PaulRB/WemosSensor/README.md

# WemosSensor
Temp/Humidity/Barometric Pressure Sensor for WeMos D1 mini
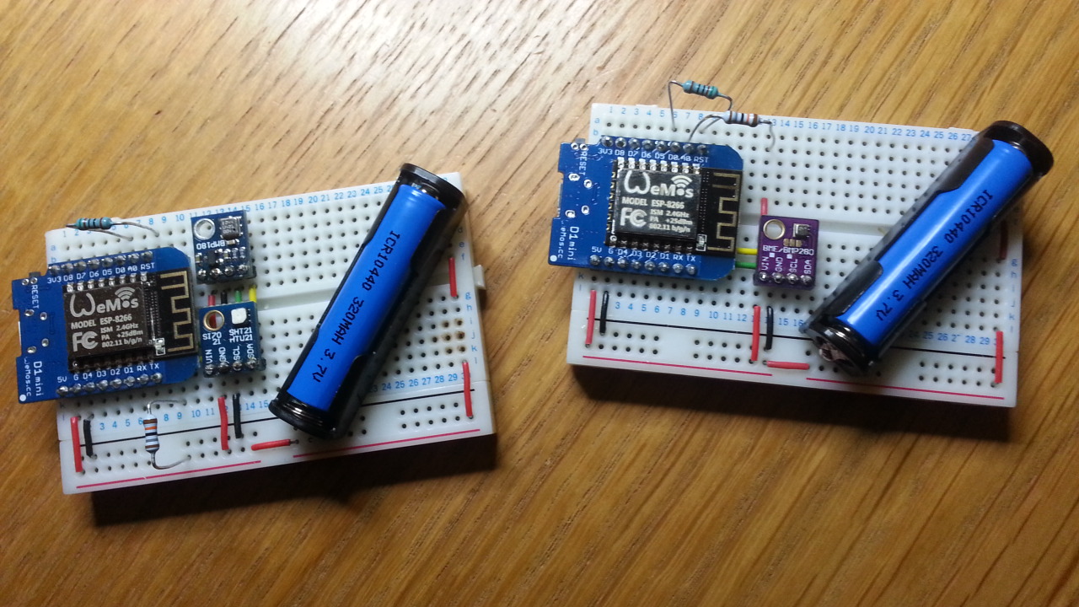
[picture p1: 20160318_220735.jpg]

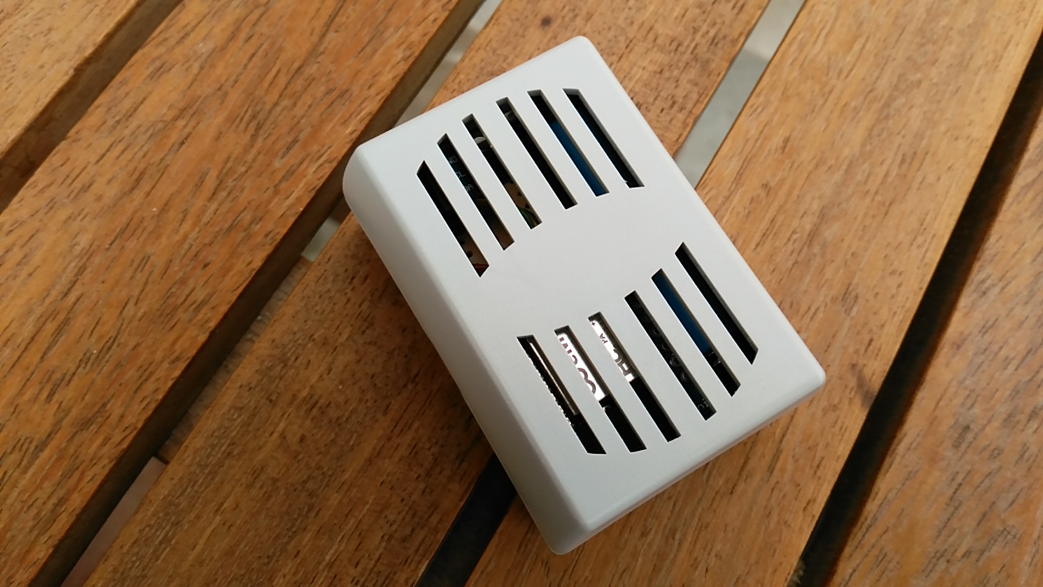
[picture p2: IMG_20160612_133524.jpg]

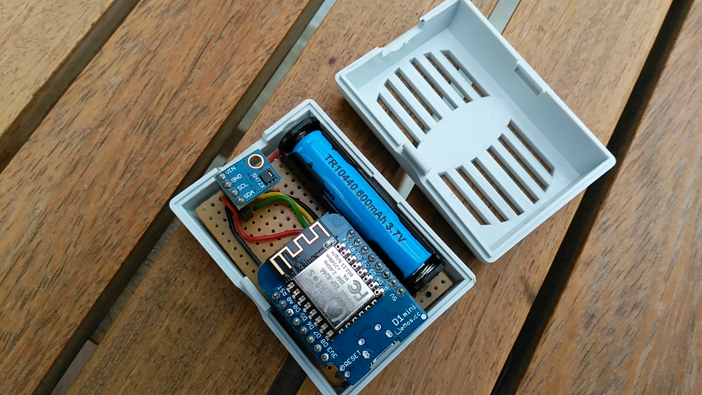
[picture p3: IMG_20160612_133540.jpg]

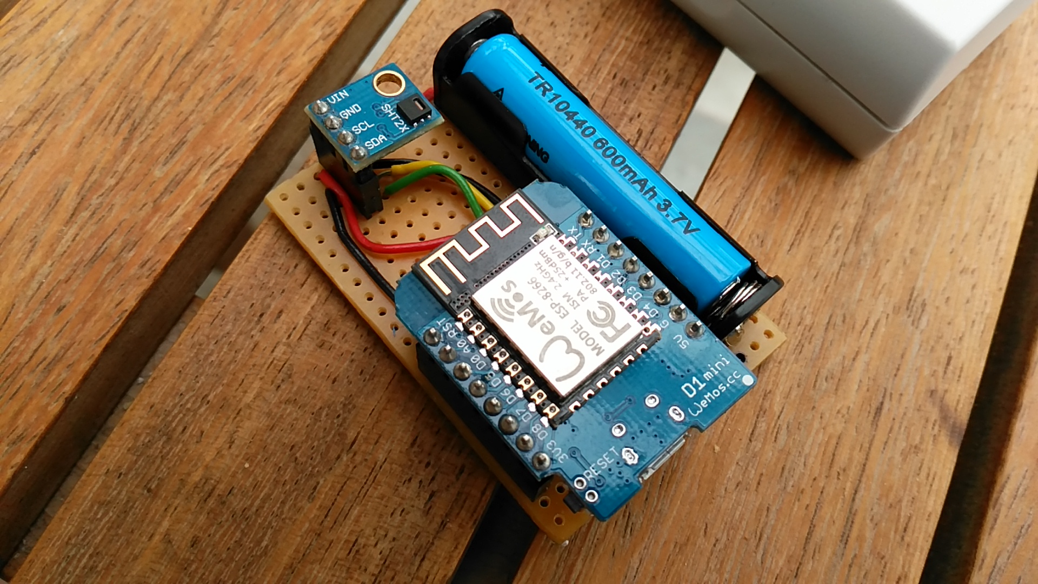
[picture p4: IMG_20160612_133556.jpg]

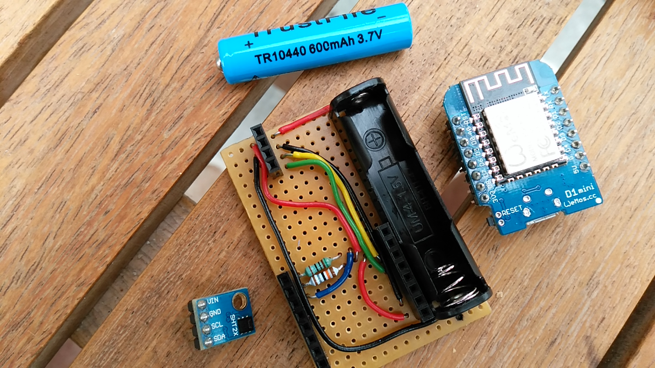
[picture p5: IMG_20160612_133626.jpg]

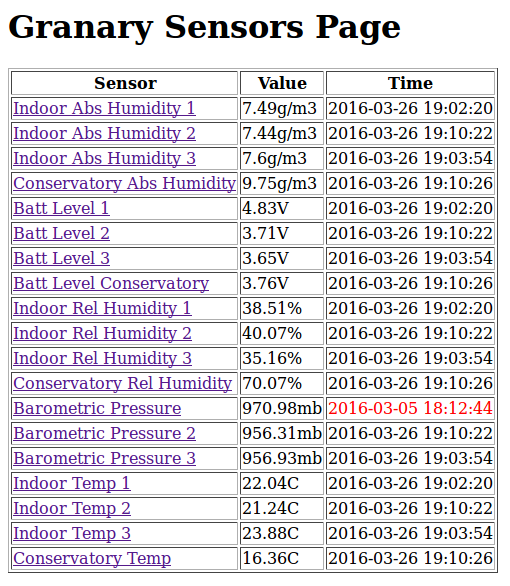
[picture p6: Screenshot from 2016-03-26 19:14:13.png]

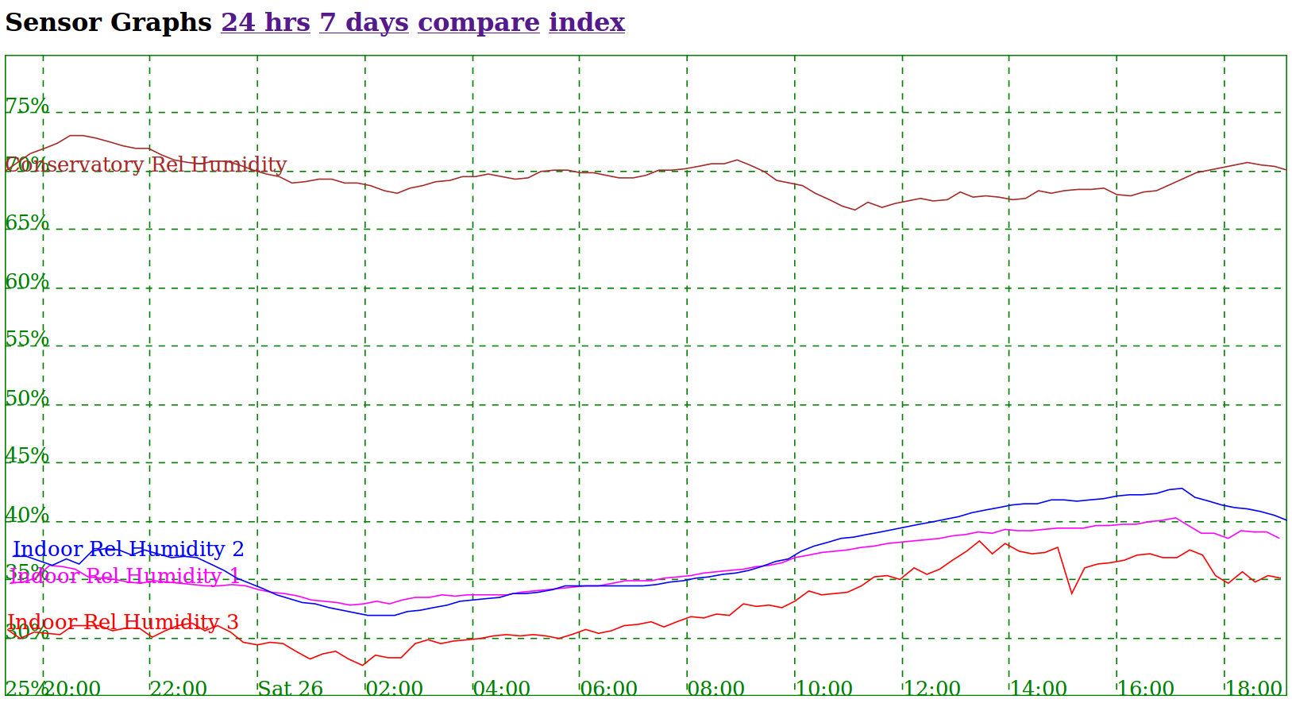
[picture p7: Screenshot from 2016-03-26 19:15:49.png]

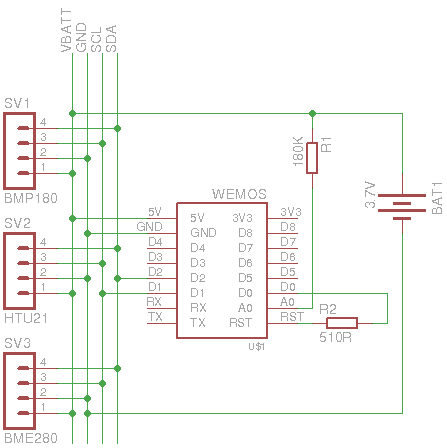
[picture p8: Schematic.png]
