PaulRB/WemosSensor/Sensor.sch

## EAGLE design Sensor.sch (2016-04-23)

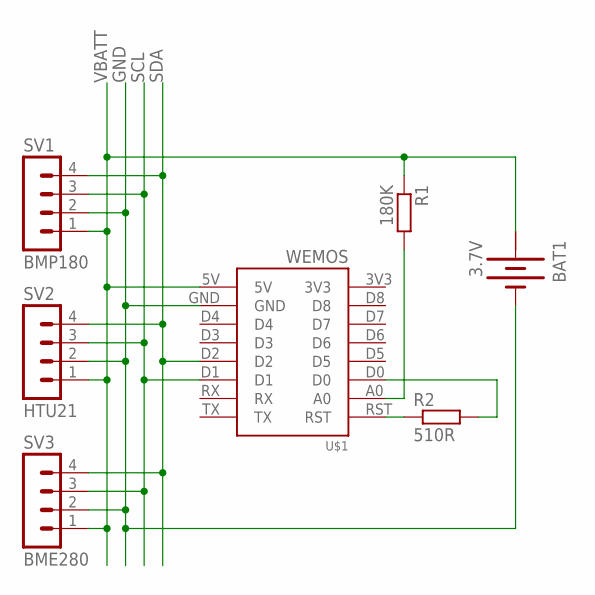
[picture p9: schematic Sensor.sch]

Parts:
BAT1: 3.7V; BATTERY
R1: 180K; 0204/5
R2: 510R; 0204/5
SV1: BMP180; MA04-1
SV2: HTU21; MA04-1
SV3: BME280; MA04-1
U$1: WEMOS

Connections:
GND: BAT1.-, SV1.2, SV2.2, SV3.2, U$1.GND
unnamed: R2.1, U$1.RST
unnamed: R2.2, U$1.D0
unnamed: R1.2, U$1.A0
SCL: SV1.3, SV2.3, SV3.3, U$1.D1
SDA: SV1.4, SV2.4, SV3.4, U$1.D2
VBATT: BAT1.+, R1.1, SV1.1, SV2.1, SV3.1, U$1.5V
