PaulRB/WemosSensor/(threads)

Thread 1 (2016-11-07):

SDA/SCL Init

anthonyjclarke, 2016-11-07:
Hi Paul, not sure if this is the right way to "comment" here, but been using this code successfully on Wemos Mini v1... changed to a HTU sensor AND a new PRO board and could get no reads until I inserted "Wire.begin(D1, D2);"

Using latest Arduino IDE @ this time.

PaulRB, 2016-11-14:
Hi Anthony. Thanks for raising this. But can I just check that you did not swap over the SDA and SCL lines when you re-made the circuit with the Mini Pro?

I think the links below indicate that Wire.begin() is equivalent to Wire.begin(D2, D1) rather than Wire.begin(D1, D2)

https://www.wemos.cc/product/d1-mini-pro.html

http://esp8266.github.io/Arduino/versions/2.0.0/doc/libraries.html#i2c-wire-library

anthonyjclarke, 2016-11-15:
Away from device at moment, will check in a few days and come back to you...

anthonyjclarke, 2016-12-04:
Something strange here.... I checked, SCL -> D1 and SDA -> D2.
Using new Wemos Pro, here are excerpts of code to get an HTU Sensor to work
 Serial.println("Starting Wire");
  //Wire.begin(D1, D2);
  //Wire.begin(2, 0); // For ESP-01
  Serial.println("Wire started");
Seems strange... doesnt it... or am I missing the bl***y obvious! :)

PaulRB, 2016-12-04:
Hi Anthony. Yes, a little strange, but, on the other hand, the line in question is commented out. Where did you find that code?

anthonyjclarke, 2016-12-05:
ok, my bad in the post... but weird anyway.

Using Wemos D1, and your code : https://github.com/PaulRB/WemosSensor/blob/master/WiFiSensorIndoor.ino

I dont know what happened, but back to SCL -> D1 and SDA -> D2 and your original posting of Wire.begin(); and we're good...

I'm a bit new, I think I may have gone down a few rabbit holes.... sorry to bother you!

PaulRB, 2016-12-18:
No worries Anthony. I'll close the issue. Re-raise if you find you can re-produce it again.

Closed 2016-12-18.

Thread 2 (2017-05-25):

Battery directly to sensor?

Albin76, 2017-05-25:
Hi. I absolutely love your setup and I have learned loads from studying your code (and your insights on the Wemos forum) and have made a sensor by your instructions that work fine.

One thing I do not follow and would like to understand is the connection of the sensor directly to battery. Most sensors for example BMP280 have a max VCC that is lower than the max battery voltage (BMP280 is 3.6V according to datasheets) and a fully charged 10440 is approx 4.15V. Connecting them directly to battery and not through the Wemos 3.3 should be more efficient since no conversion losses but is it safe/functional?

Can you explain please how you have reasoned?

PaulRB, 2017-07-09:
I should have explained in more detail. The sensor breakout boards I use all have their own 3.3V regulator on board, such as this one:
http://www.ebay.co.uk/itm/BME280-Digital-Temperature-Humidity-Barometric-Pressure
and this one:
http://www.ebay.co.uk/itm/1pcs-HTU21D-Temperature-Humidity-Sensor-Breakout

PaulRB, 2017-07-09:
If using a sensor board without its own regulator, you could use the 3.3V pin from the Wemos as you suggested.

Thanks for your feedback and appreciation!

Albin76, 2017-07-09:
Thanks. That explains a lot. I Will see if I have a regulator on mine and
connect thouse directly and by the 3.3V on the others then.

Curious about one thing. May i ask how many days you manage between charges
on a 10440 (and at what sample rate of course)?

I myself have at best 15 days between charges (4.15 to 3.45V) and have a
reading every 15 minutes and use wifi manager.

sön 9 juli 2017 kl. 12:13 skrev Paul <notifications@github.com>:

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

PaulRB, 2017-07-09:
I get around 21 days between charges. Sample rate is 15 mins. The Wemos wakes for around 5 or 6 seconds. It has a fixed ip address on my home network, so does not need to wait for DHCP to allocate an address. The battery voltage drops to around 2.6~2.8V before it stops working.

Closed 2017-07-09.

Thread 3 (2019-04-22):

Connection failed

williamesp2015, 2019-04-22:
I am using ESP32 (platform: arduino-esp32) and before I connect sensors I  tested by random values:
temperatureNow= random(20);
battLevelNow= random(10);
humidityNow= random(30);
pressureNow = random(1000);
I changed $servername and then copied four php files in my website under SQL sub-directory. When sending data it says:
.OK
WiFi connected, IP address: 192.168.0.45

connecting to www.MYURL.com
Requesting URL: /SQL/script.php?sensor=TC,BC,HC&value=17.00,1.00,17.00
HTTP/1.1 200 OK
Date: Mon, 22 Apr 2019 13:33:25 GMT
Server: Apache/2
X-Powered-By: PHP/5.4.45
Vary: Accept-Encoding,User-Agent

Connection: close
Transfer-Encoding: chunked
Content-Type: text/html

57
Connection failed: Access denied for user 'hostuserid'@'veyq.net' (using password: YES)
0

closing connection
Total time: 1115
Sleeping...!
/////////////////
I am wondering what file is the database to save data into it and How set the username and password !!!?

PaulRB, 2020-01-01:
Hi, the database is not in a "file". It is a MySQL database hosted on the same server, although it could be hosted elsewhere. Inside each of the .php files, you will see where to set the hostname of the server running mySQL, the user id, password and database name. You can decide the user id, password and database name when you create the database. In my case I did these things through an app called myPHPadmin which was also installed on the server I used, but I also provided an SQL script to create the database tables.

Closed 2021-03-20.
